Secret350/Pan-Tilt-Tracking-Camera/train/progress_snapshot.png

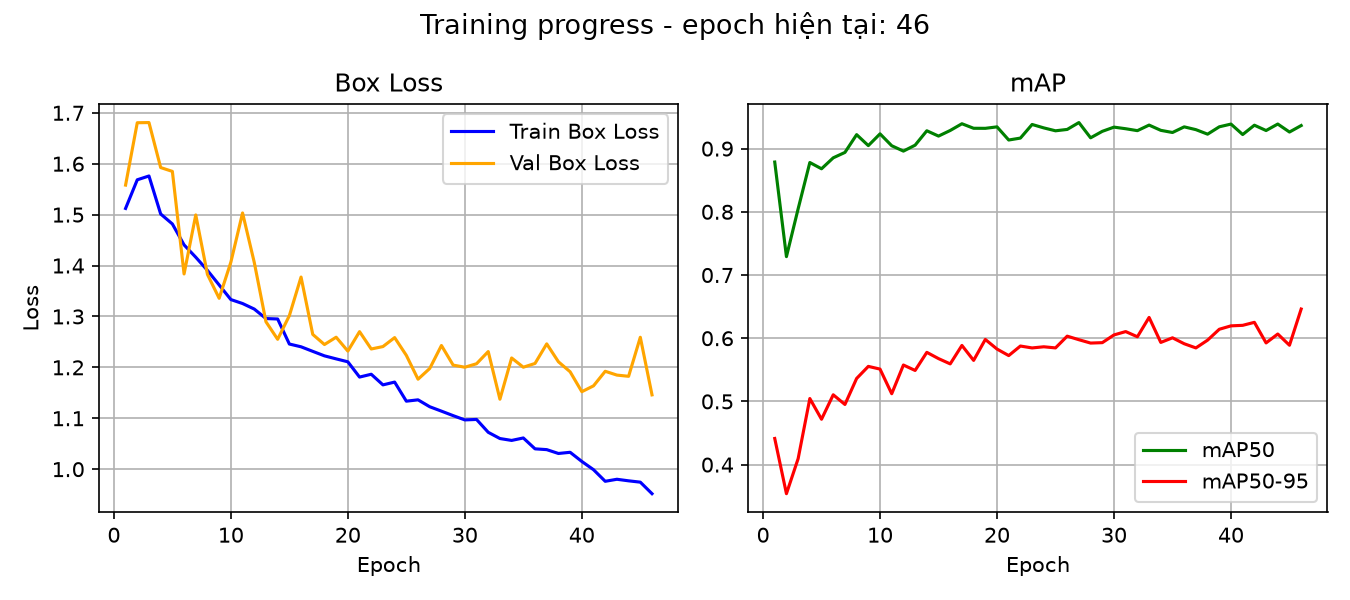
train/progress_snapshot.png
