Secret350/Pan-Tilt-Tracking-Camera/train/progress_snapshot_scut.png

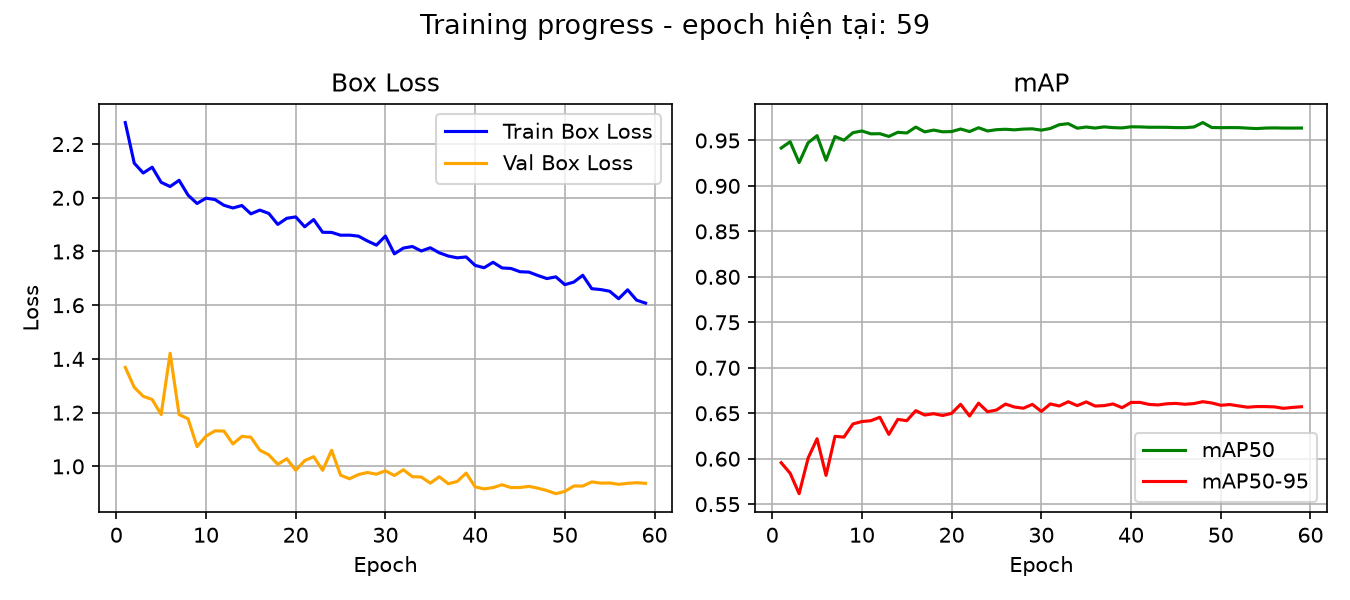
train/progress_snapshot_scut.png
