Secret350/Pan-Tilt-Tracking-Camera/train/progress_snapshot_update.png

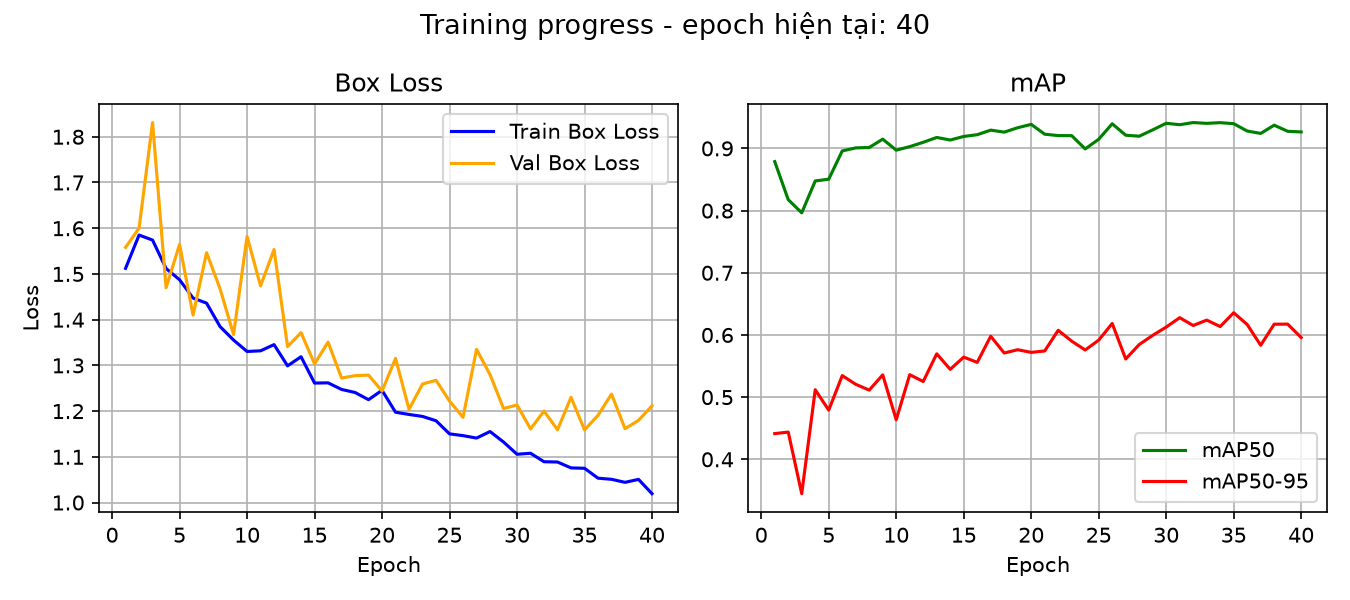
train/progress_snapshot_update.png
