Secret350/Pan-Tilt-Tracking-Camera/train/progress_snapshot_update_continue.png

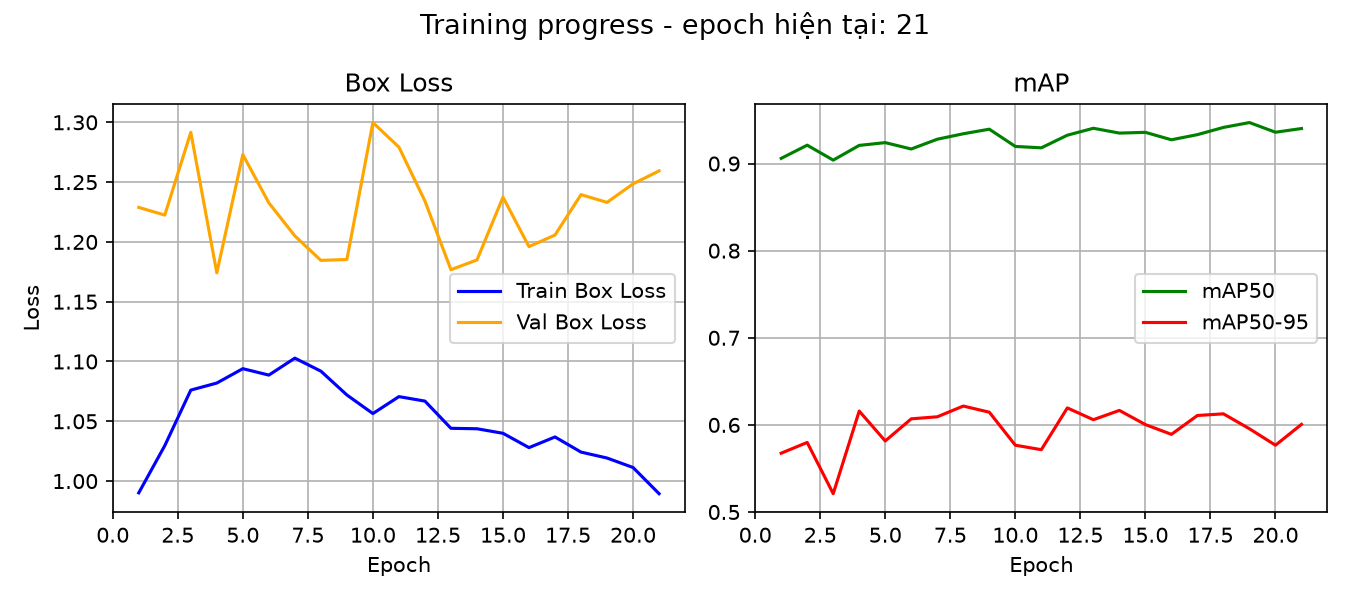
train/progress_snapshot_update_continue.png
