Secret350/Pan-Tilt-Tracking-Camera/project_des/pan_tilt_wiring.png

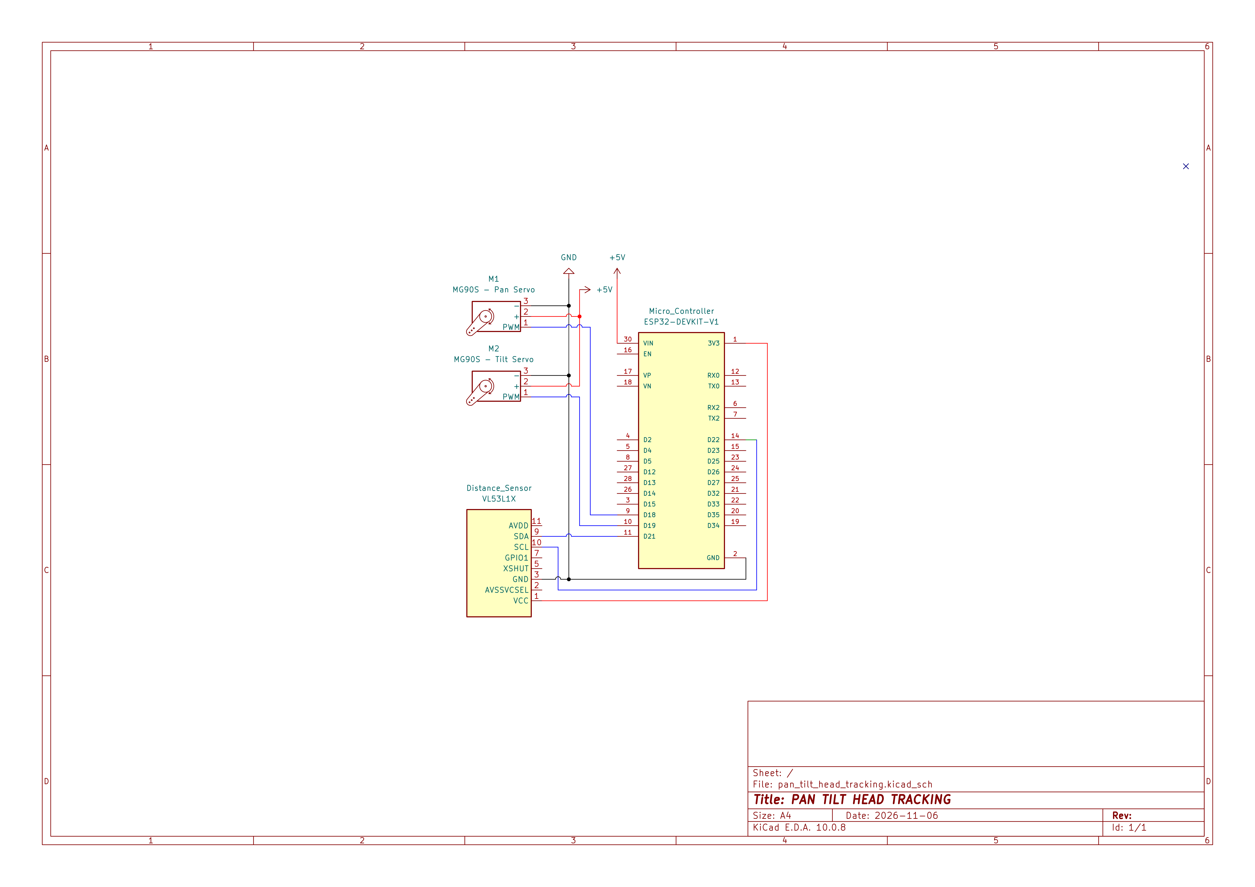
project_des/pan_tilt_wiring.png
