Secret350/Pan-Tilt-Tracking-Camera/(commit log)

2026-10-23 initial Pan-tilt Tracking Camera repository
    [pid_params.json, tracking_log.csv, vl53l0x_angle_20261014_231007.csv]
2026-11-05 Bổ sung xử lí vẽ mask cho khuôn mặt bằng mediapipe
    [pid_params.json, tracking_log.csv]
2026-11-05 Chuyển sang sử dụng opencv5, thêm requirements.txt
    [tracking_log.csv]
2026-11-06 Bổ sung tính năng đo khoảng cách bằng thư viện opencv5 và so sánh với thông số khoảng cách nhận từ cảm biến TOF400C-VL53L1X
2026-11-06 Hoàn thiện README.MD - Đợi file video demo, bản vẽ kỹ thuật và sơ đồ mạch điện
2026-11-06 Bổ sung thêm thành phần trong gitignore
2026-11-06 Bổ sung ảnh kiến trúc dự án
2026-11-06 Bổ sung requirements.txt
2026-11-06 Sửa đổi gitignore
2026-11-06 Điều chỉnh README.MD và requirements.txt
    [tracking_log.csv]
2026-11-06 Bổ sung sơ đồ mạch điện
2026-11-07 Thêm bản vẽ cơ khí và sơ đồ mạch điện, điều chỉnh README.MD và .gitignore
2026-11-07 Chỉnh sửa README.MD
2026-11-09 Chuyển đổi để sử dụng cảm biến TOF400C-VL53L1X
    [tracking_log.csv, vl53l0x_angle_20261014_231007.csv]
