Secret350/Pan-Tilt-Tracking-Camera/(notices)

Notices in the files:
README.MD:
License: Apache
